Lameguy64/ps2serial/schematic.png

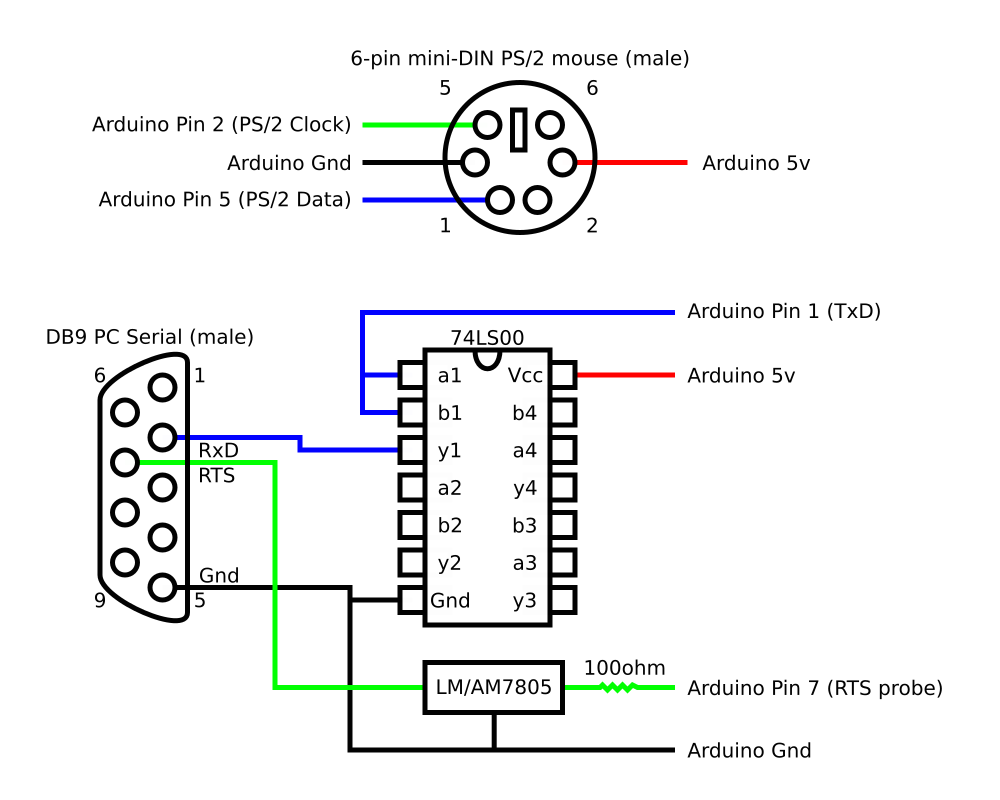
schematic.png
