Lameguy64/ps2serial/(threads)

Thread 1 (2020-06-23):

Using RS232 to TTL adapter

ssshake, 2020-06-23:
Hi hope you dont mind me asking this question here. I was wondering if your code could be used with this RS232 to TTL adapter. I ask because I have a box of them, and I've used them with other vintage pc projects (building wifi modems).

I'm not familiar with the components you list in your readme. I'm wondering if those components and this adapter serve the same purpose.

Thanks!

corvus1, 2022-08-10:
yes, you can absolutely use a max232, however, it might require a small change in software for RTS sensing.

Lameguy64, 2022-08-19:
It bugs me people are still using this clumsy implementation of mine over my successor of this, but then the fact it is written in AVR assembly is likely a deterrent to most from adopting it.

corvus1, 2022-08-19:
@Lameguy64 Any links to the successor implementation?
Although, I gotta say, it might be clumsy, but it's easy to understand and change if need be.

corvus1, 2022-08-19:
So, I found your asm implementation, and it's cool and everything, but I for one really don't want to dig into AVR assembly. If it's performance you're after, you can get a RasPi Pico or a blackpill clone from aliexpress for the price of an arduino nano, which is about 3 bucks. And it will have a proper USB interface, which will allow you to use any old usb mouse, and it has 20 times the performance, while the same power consumption, and you can program in micro python if you so choose, which is a lot easier to understand. So why all the assembly?

What bugs me really is that ttl-rs232 coverter boards from ali only connect 1 line in and 1 line out. So you can either have the RTS sense, or software configuration. Despite max232 having 2 lines in each direction, they just aren't connected.

Thread 3 (2022-08-09):

Fix the typo in the schematic.

corvus1, 2022-08-09:
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

https://github.com/Lameguy64/ps2serial/blob/7388d17d15b904093e17e603f34beaaaed3f1293/ps2serial.ino#L56

It's pin4, but the schematic says pin5.
