Lameguy64/ps2serial/(commit log)

2018-01-25 Fixed mouse button issues
    [ps2serial.ino]
2018-02-27 Switched to MS protocol and added single UART compatibility
